Diogo-Spencer/PAC/bomba backup/bomba backup all.SLDASM

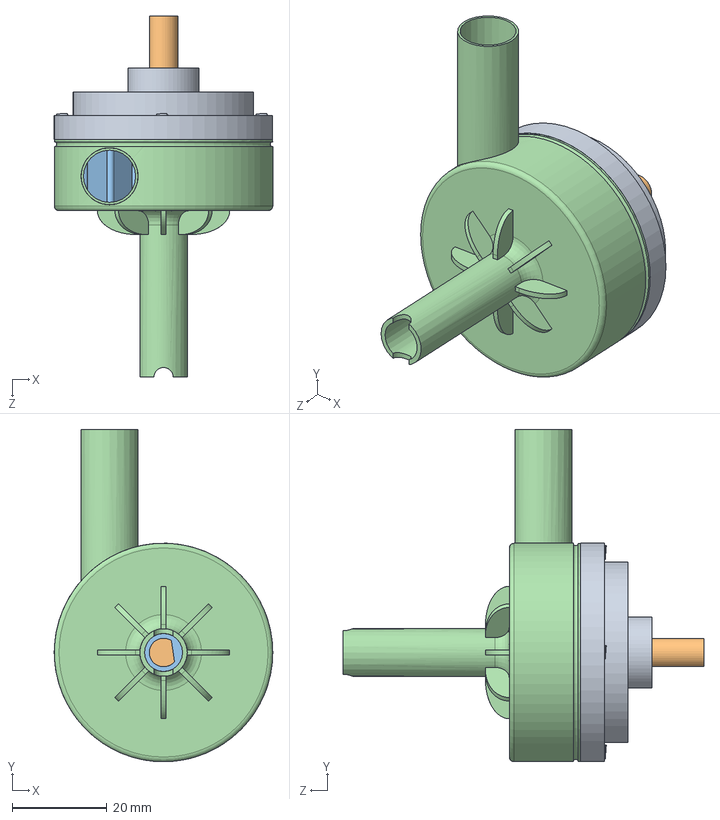
[picture p88: CAD file, 2023-11-21]
bomba backup/bomba backup all.SLDASM
46.0 x 70.0 x 76.0 mm
bomba backup
hélice backup
veio backup
tampa backup
