Diogo-Spencer/PAC/Bomba 80mm/Assem 80mm.SLDASM

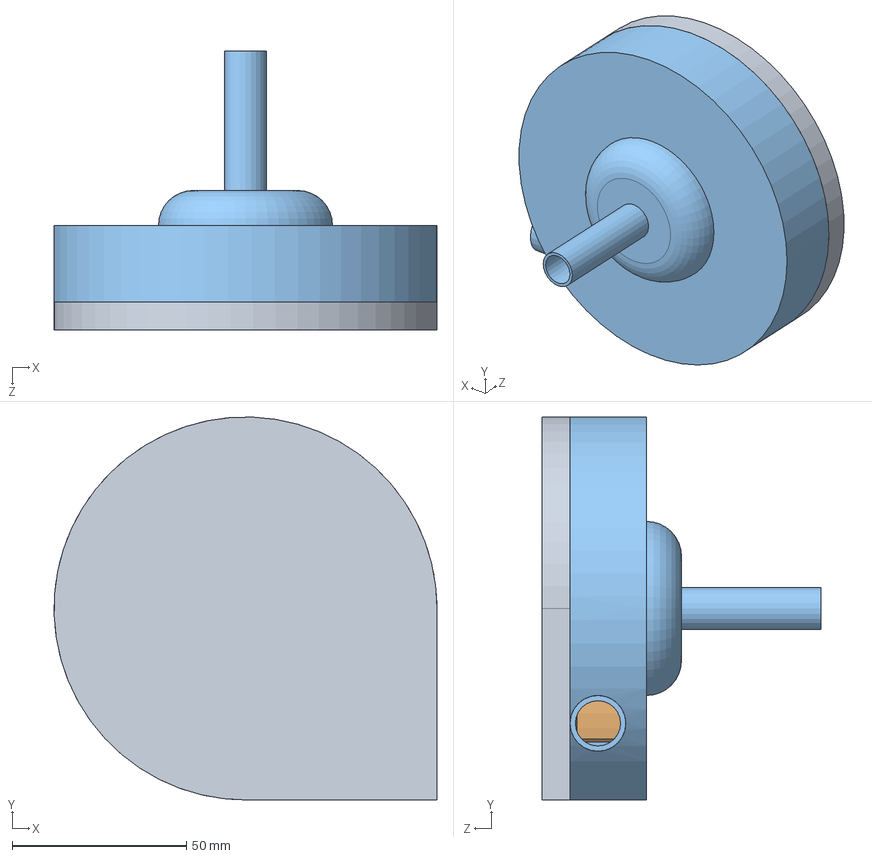
[picture p89: CAD file, 2023-11-29]
Bomba 80mm/Assem 80mm.SLDASM
110.0 x 110.0 x 80.0 mm
Bomba 100mm
Hélice 100 mm
Tampa 80mm
