Diogo-Spencer/PAC/Assem fred.SLDASM

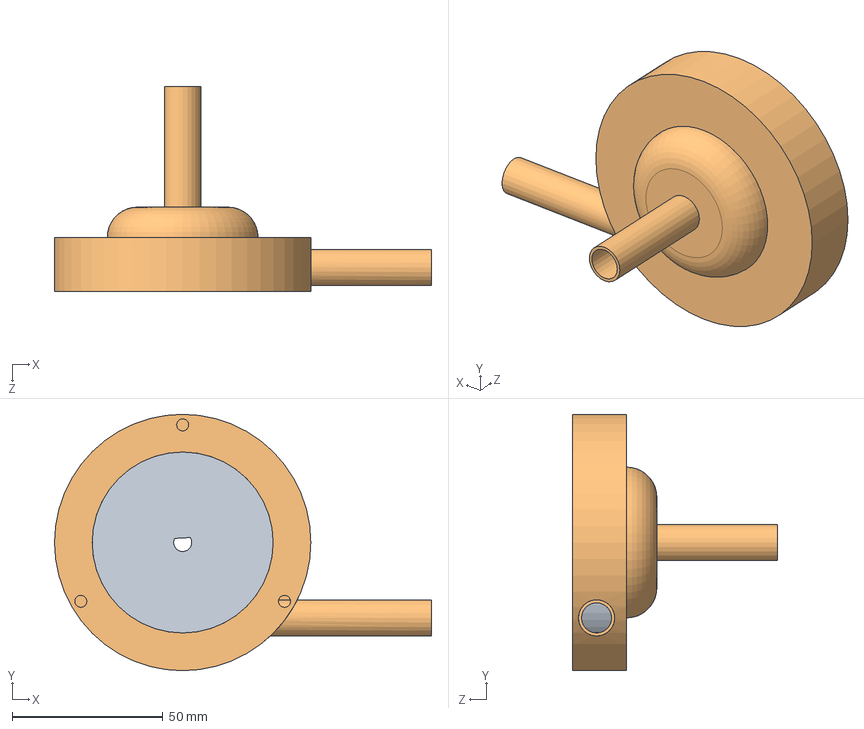
[picture p90: CAD file, 2023-11-28]
Assem fred.SLDASM
125.0 x 85.0 x 68.0 mm
bomba3 fred
helice nova bomba spencer
