Diogo-Spencer/PAC/Bomba Definitiva/Assembley Bomba.SLDASM

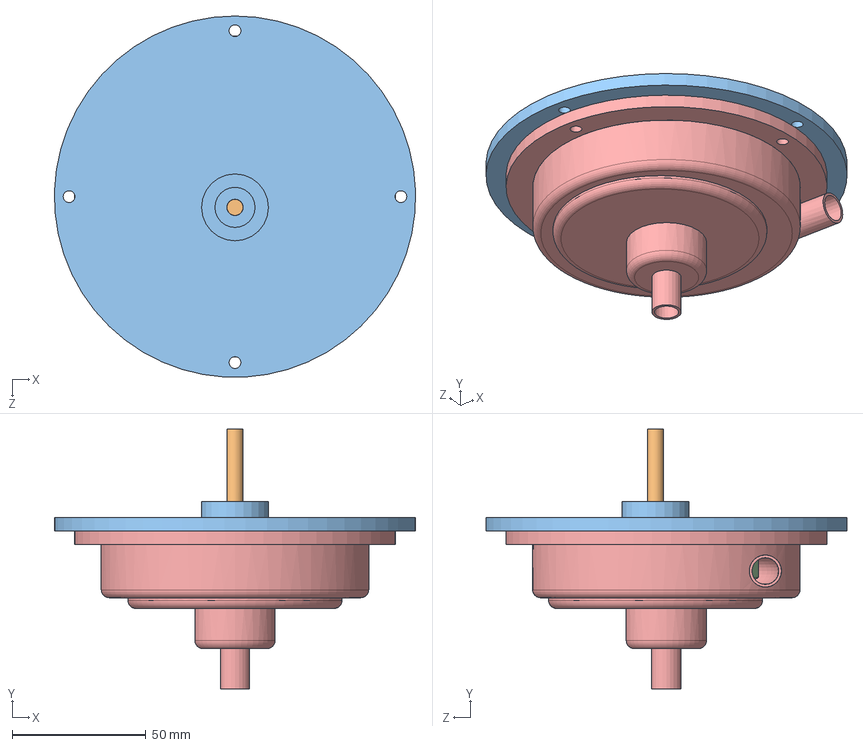
[picture p91: CAD file, 2023-12-01]
Bomba Definitiva/Assembley Bomba.SLDASM
134.9 x 97.0 x 134.9 mm
bomba
hélice
tampa2
Veio
O-ring
