Diogo-Spencer/PAC/Testes e Exames/sim.SLDASM

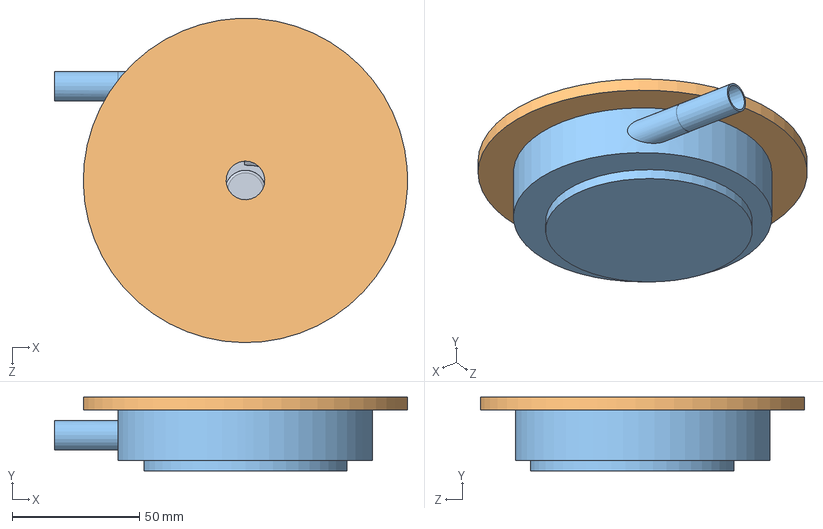
[picture p92: CAD file, 2023-11-30]
Testes e Exames/sim.SLDASM
138.6 x 29.0 x 127.3 mm
bomba simulação
tampa simulação
hélice
