Diogo-Spencer/PAC/Bomba 80mm/Bomba 80mm.SLDPRT

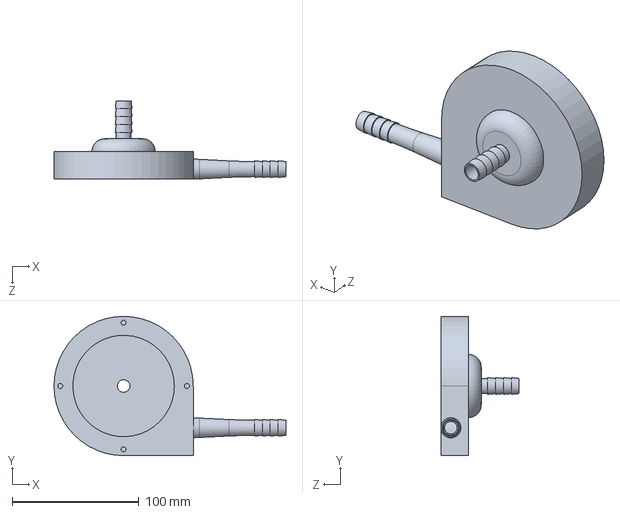
[picture p93: CAD file, 2023-11-30]
Bomba 80mm/Bomba 80mm.SLDPRT
183.3 x 110.0 x 62.0 mm
