Diogo-Spencer/PAC/bomba backup/hélice backup.SLDPRT

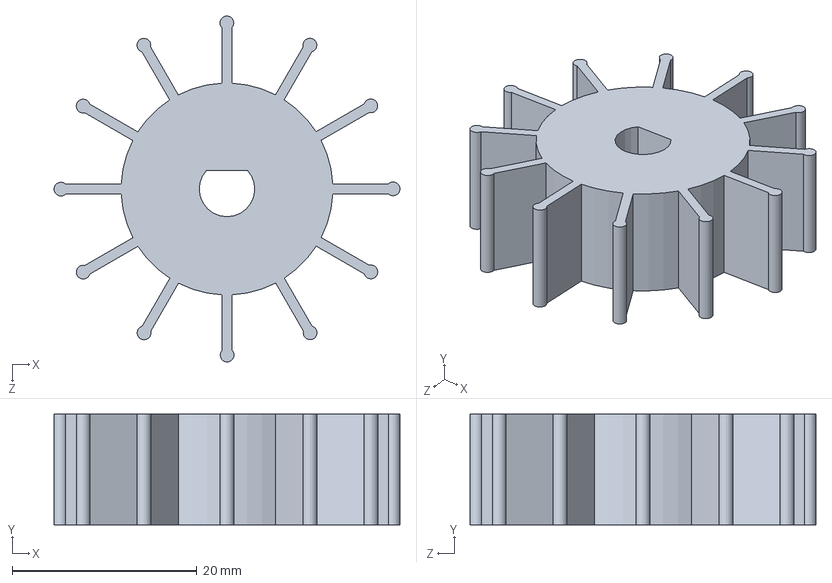
[picture p94: CAD file, 2023-11-21]
bomba backup/hélice backup.SLDPRT
37.4 x 12.0 x 37.4 mm
