Diogo-Spencer/PAC/Bomba Definitiva/hélice 3.SLDPRT

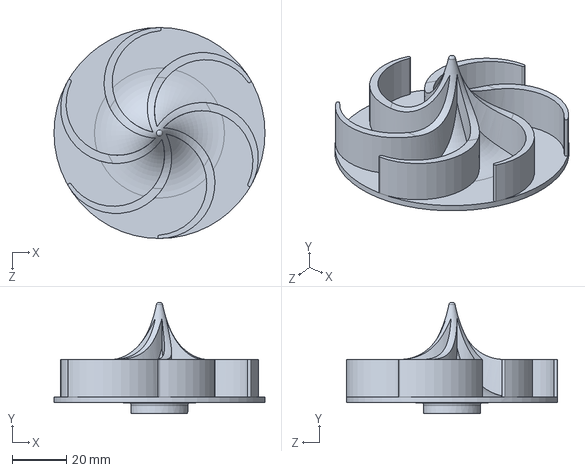
[picture p95: CAD file, 2023-12-06]
Bomba Definitiva/hélice 3.SLDPRT
78.0 x 41.1 x 78.0 mm
