Diogo-Spencer/PAC/bomba.3mf

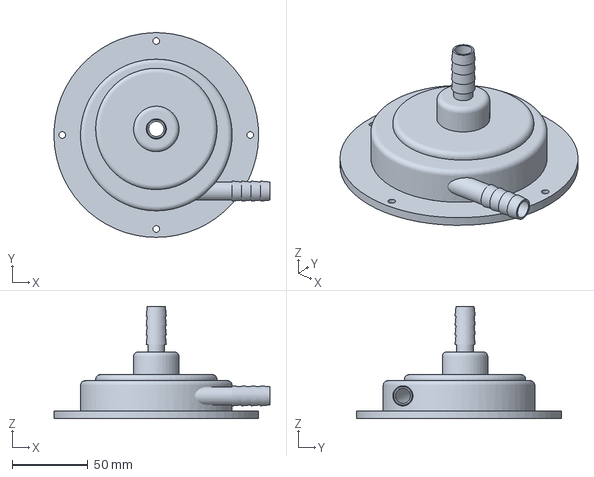
[picture p96: CAD file, 2023-12-04]
bomba.3mf
142.5 x 135.0 x 74.0 mm
