Diogo-Spencer/PAC/Testes e Exames/hélice.SLDPRT

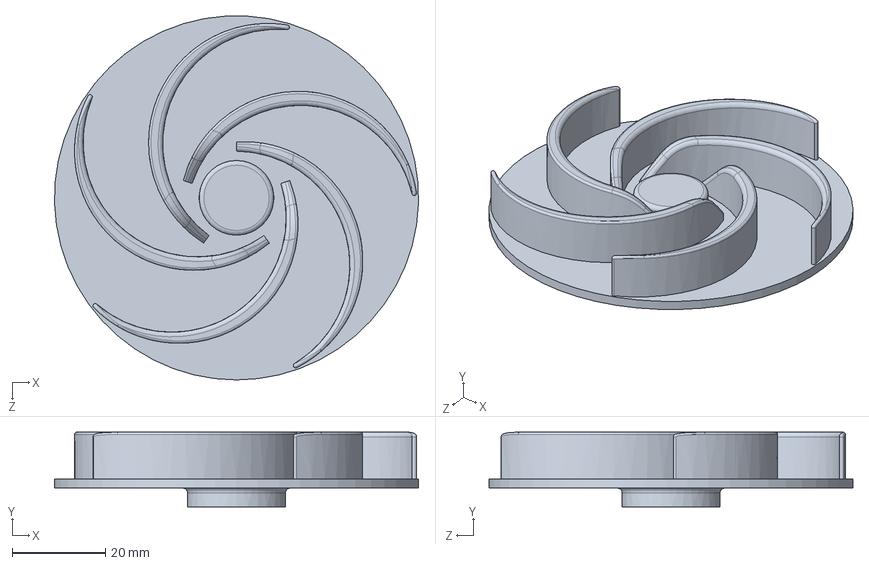
[picture p97: CAD file, 2023-11-30]
Testes e Exames/hélice.SLDPRT
78.0 x 16.0 x 77.9 mm
