Diogo-Spencer/PAC/Bomba 80mm/Hélice 80mm.SLDPRT

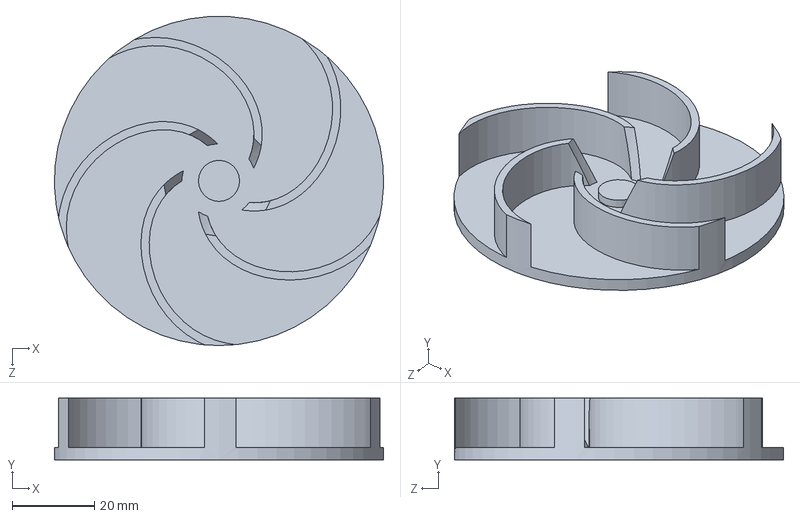
[picture p98: CAD file, 2023-11-30]
Bomba 80mm/Hélice 80mm.SLDPRT
80.0 x 15.0 x 79.9 mm
