Diogo-Spencer/PAC/bomba backup/bomba backup.SLDPRT

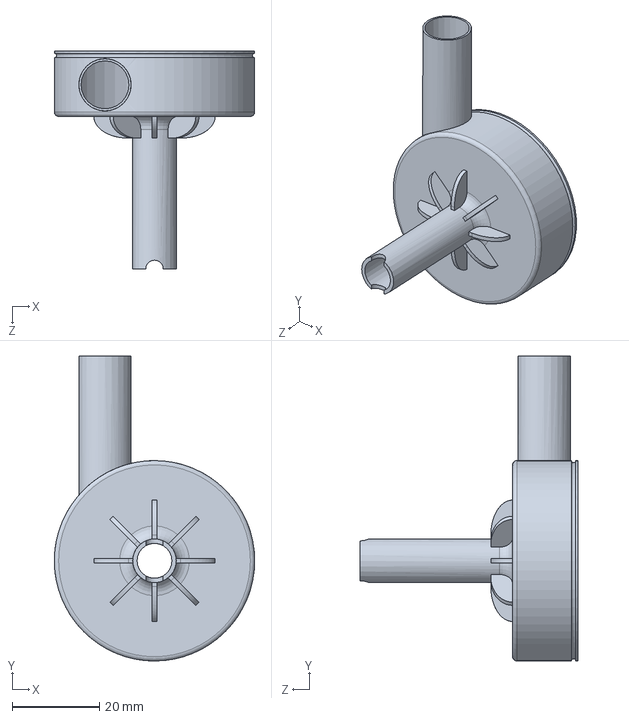
[picture p99: CAD file, 2023-11-21]
bomba backup/bomba backup.SLDPRT
46.0 x 70.0 x 50.0 mm
