Diogo-Spencer/PAC/Bomba Definitiva/hélice 2.SLDPRT

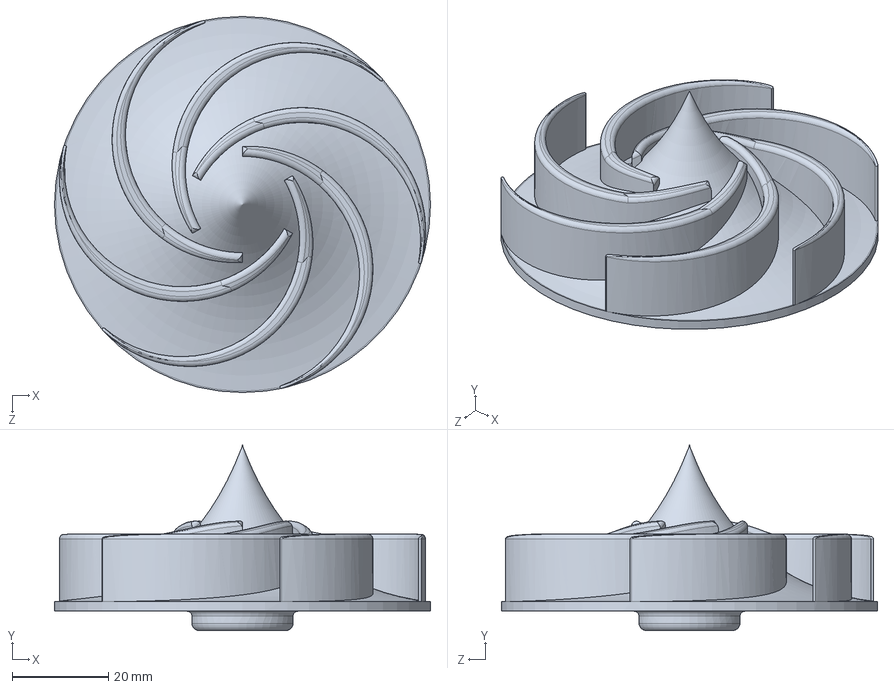
[picture p100: CAD file, 2023-12-06]
Bomba Definitiva/hélice 2.SLDPRT
78.0 x 38.4 x 78.0 mm
