Diogo-Spencer/PAC/Hélice 100 mm.SLDPRT

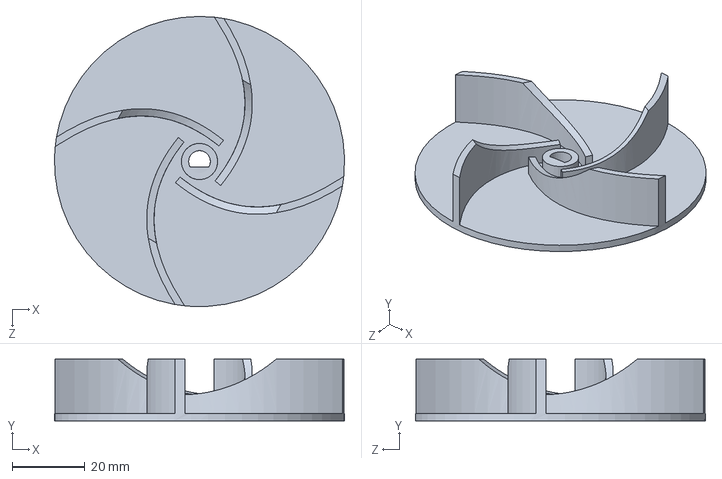
[picture p101: CAD file, 2023-11-28]
Hélice 100 mm.SLDPRT
80.0 x 17.0 x 80.0 mm
