Diogo-Spencer/PAC/sld/veio 3.SLDPRT

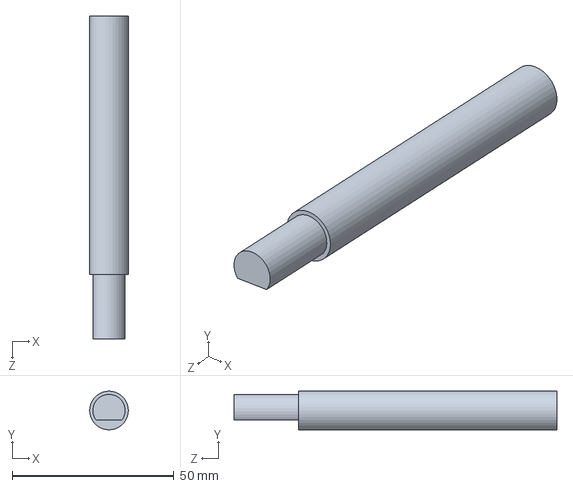
[picture p102: CAD file, 2023-11-26]
sld/veio 3.SLDPRT
12.0 x 12.0 x 100.0 mm
