Diogo-Spencer/PAC/Testes e Exames/bomba.SLDPRT

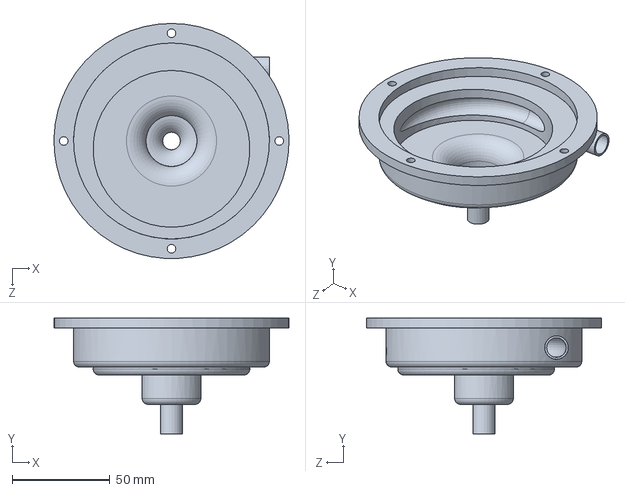
[picture p103: CAD file, 2023-11-30]
Testes e Exames/bomba.SLDPRT
119.9 x 59.0 x 120.0 mm
