Diogo-Spencer/PAC/Bomba 100mm.SLDPRT

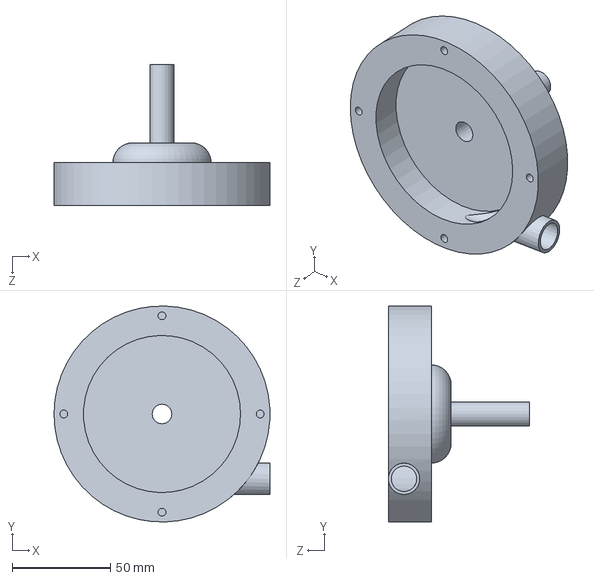
[picture p104: CAD file, 2023-11-28]
Bomba 100mm.SLDPRT
110.0 x 109.9 x 72.0 mm
