Diogo-Spencer/PAC/Bomba 80mm/dummy.SLDPRT

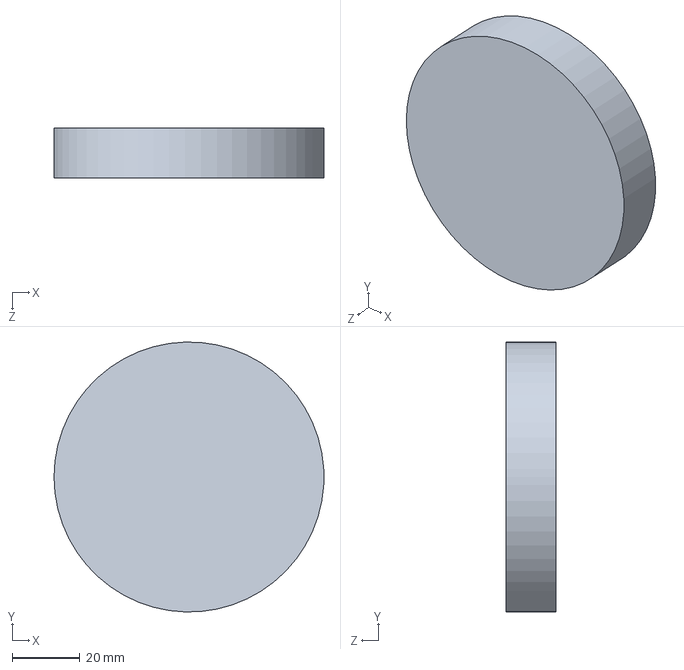
[picture p105: CAD file, 2023-11-30]
Bomba 80mm/dummy.SLDPRT
79.9 x 79.9 x 14.9 mm
