Diogo-Spencer/PAC/bomba backup/veio backup.SLDPRT

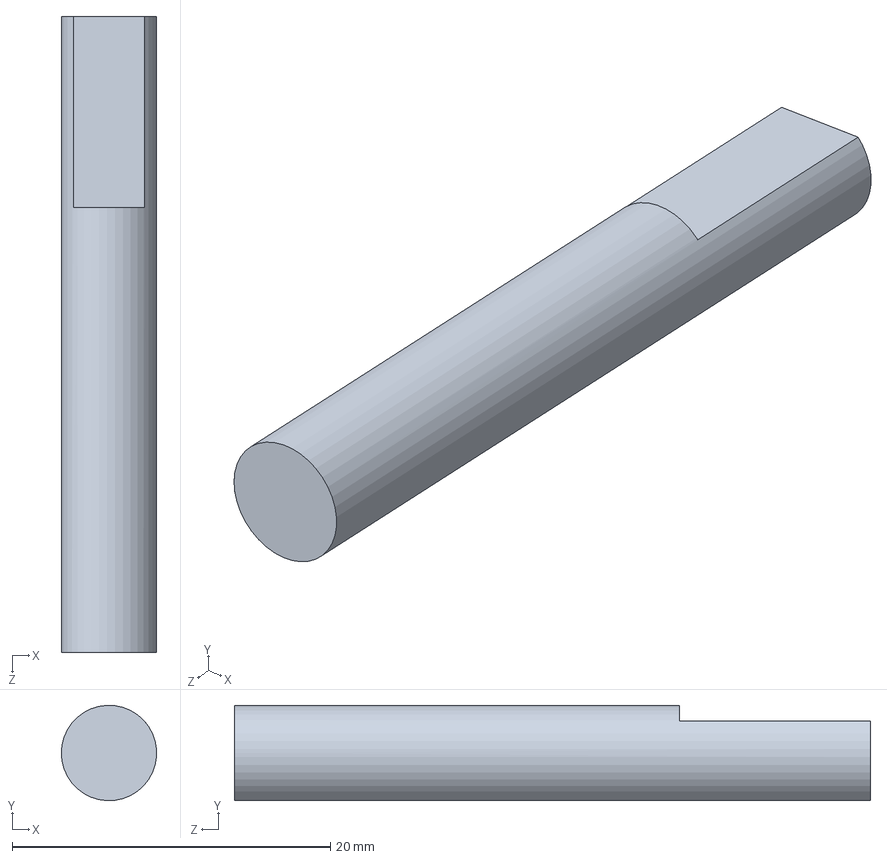
[picture p106: CAD file, 2023-11-21]
bomba backup/veio backup.SLDPRT
6.00 x 5.99 x 40.0 mm
