Diogo-Spencer/PAC/sld/dummy 3.SLDPRT

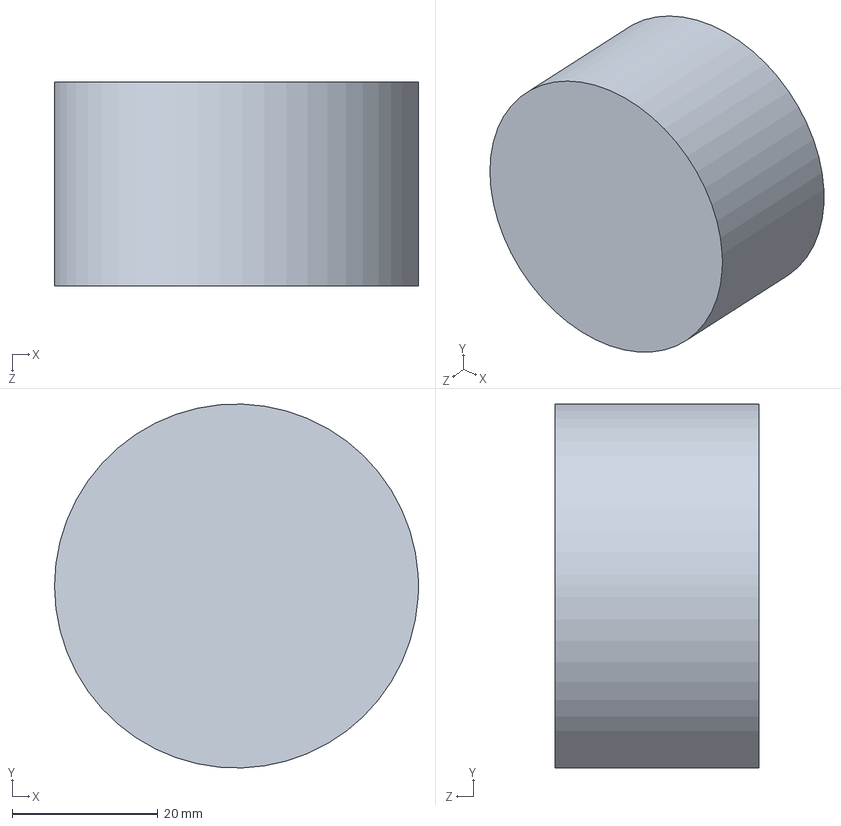
[picture p107: CAD file, 2023-11-26]
sld/dummy 3.SLDPRT
50.0 x 50.0 x 28.0 mm
