Diogo-Spencer/PAC/Testes e Exames/dumy.SLDPRT

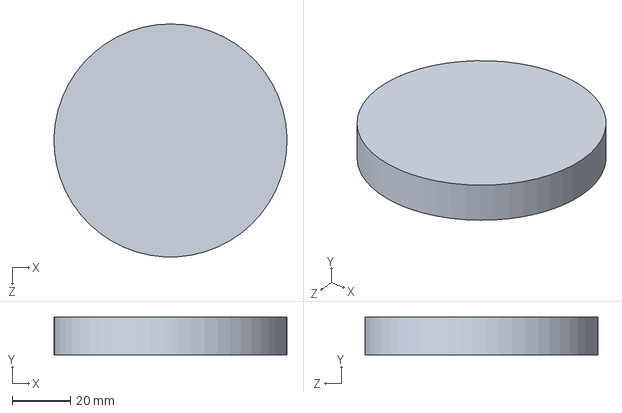
[picture p108: CAD file, 2023-11-30]
Testes e Exames/dumy.SLDPRT
80.0 x 13.0 x 80.0 mm
