Diogo-Spencer/PAC/Bomba 80mm/Tampa 80mm.SLDPRT

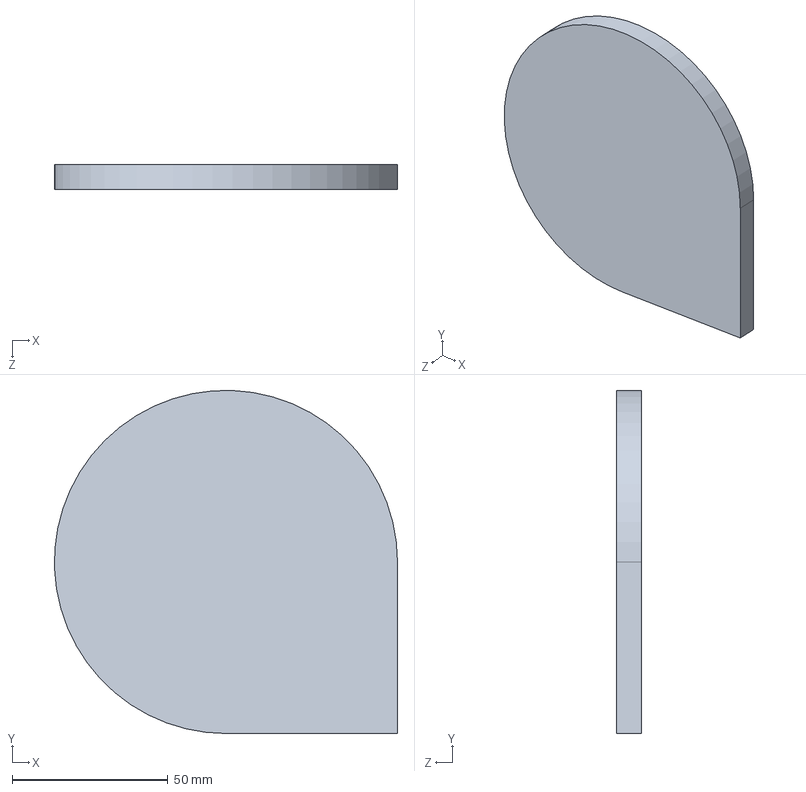
[picture p109: CAD file, 2023-11-29]
Bomba 80mm/Tampa 80mm.SLDPRT
110.0 x 110.0 x 8.00 mm
