Diogo-Spencer/PAC/Bomba Definitiva/hélice.SLDPRT

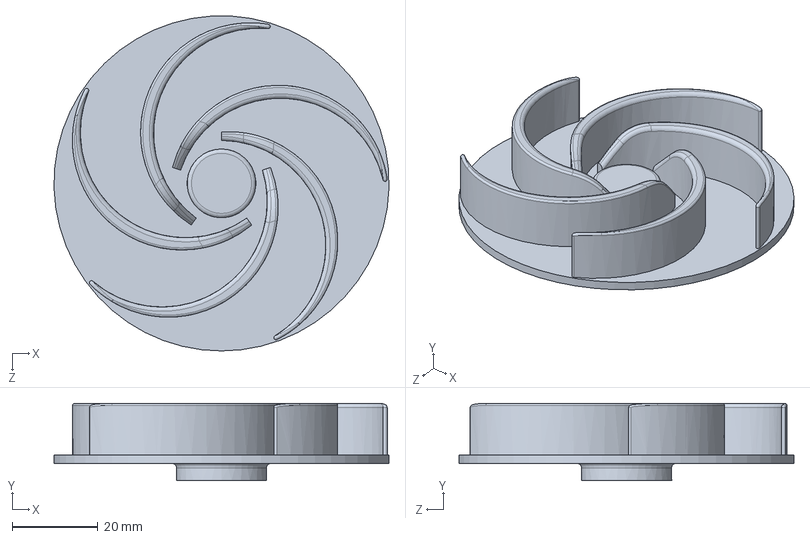
[picture p110: CAD file, 2023-12-01]
Bomba Definitiva/hélice.SLDPRT
78.0 x 18.0 x 77.9 mm
