Diogo-Spencer/PAC/helice nova bomba spencer 8 pazes.SLDPRT

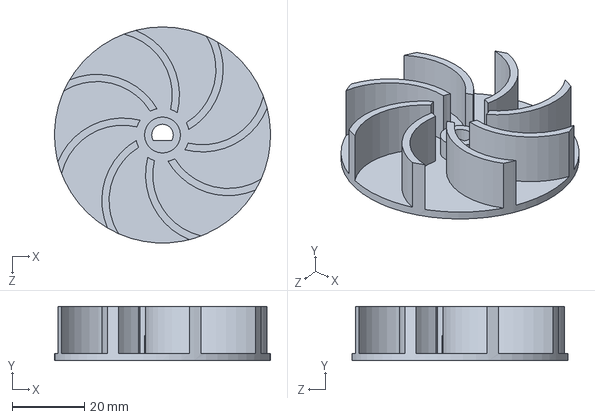
[picture p111: CAD file, 2023-11-28]
helice nova bomba spencer 8 pazes.SLDPRT
60.0 x 15.0 x 60.0 mm
