Diogo-Spencer/PAC/bomba backup/tampa backup.SLDPRT

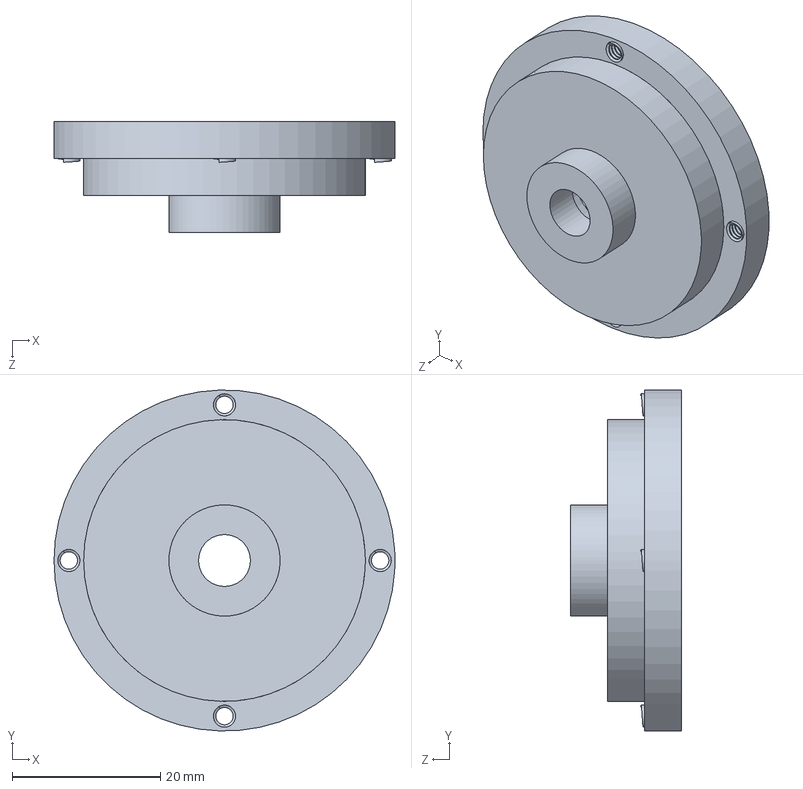
[picture p112: CAD file, 2023-11-21]
bomba backup/tampa backup.SLDPRT
46.0 x 46.0 x 15.0 mm
