Diogo-Spencer/PAC/Bomba Definitiva/tampa2.SLDPRT

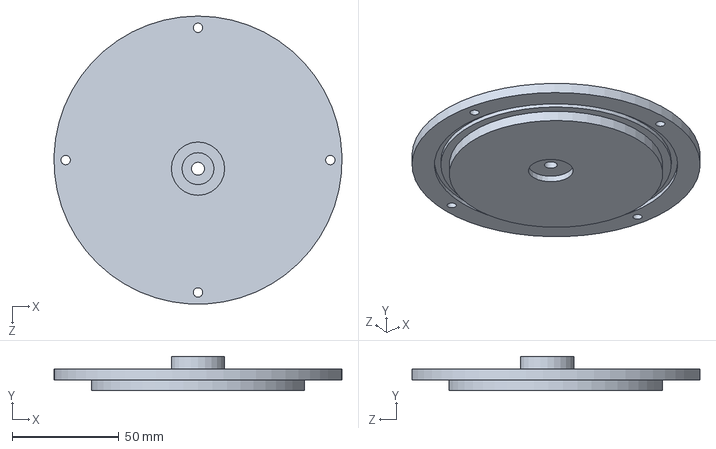
[picture p113: CAD file, 2023-12-01]
Bomba Definitiva/tampa2.SLDPRT
134.9 x 16.0 x 134.9 mm
