Diogo-Spencer/PAC/helice nova bomba spencer 4 pazes.SLDPRT

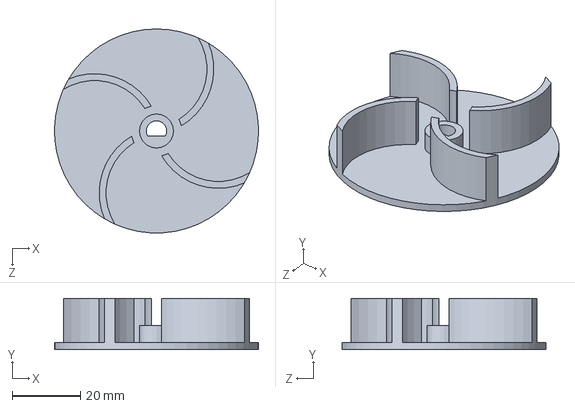
[picture p114: CAD file, 2023-11-28]
helice nova bomba spencer 4 pazes.SLDPRT
60.0 x 15.0 x 60.0 mm
