Diogo-Spencer/PAC/Testes e Exames/tampa simulação.SLDPRT

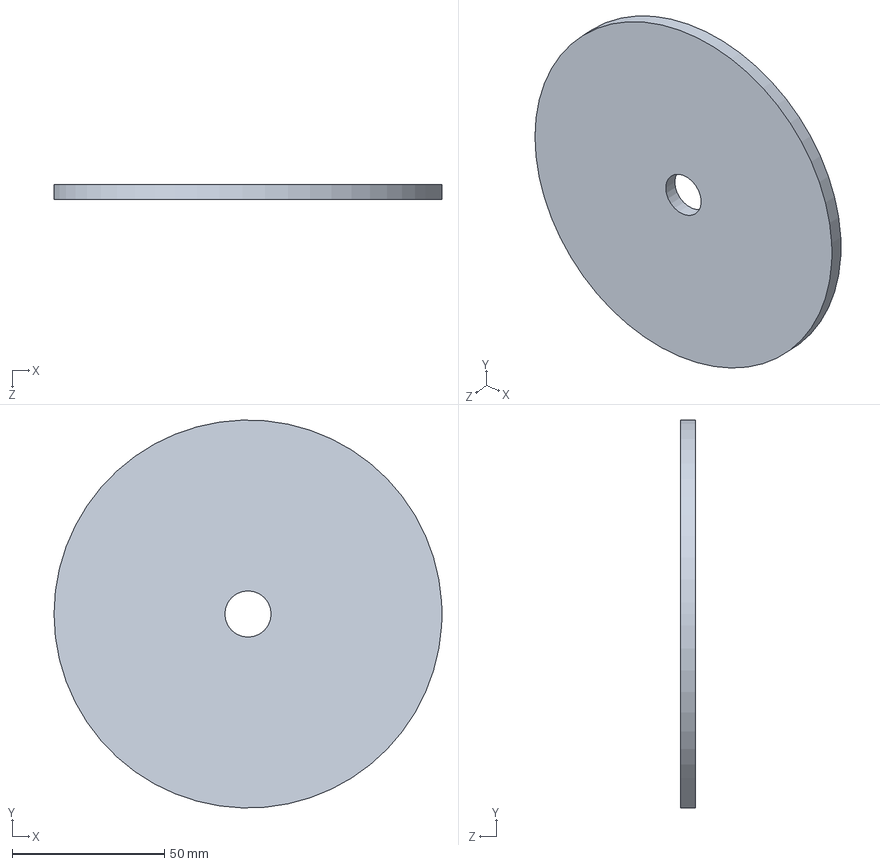
[picture p115: CAD file, 2023-11-30]
Testes e Exames/tampa simulação.SLDPRT
127.4 x 127.3 x 5.00 mm
