Diogo-Spencer/PAC/bomba backup/dummy backup.SLDPRT

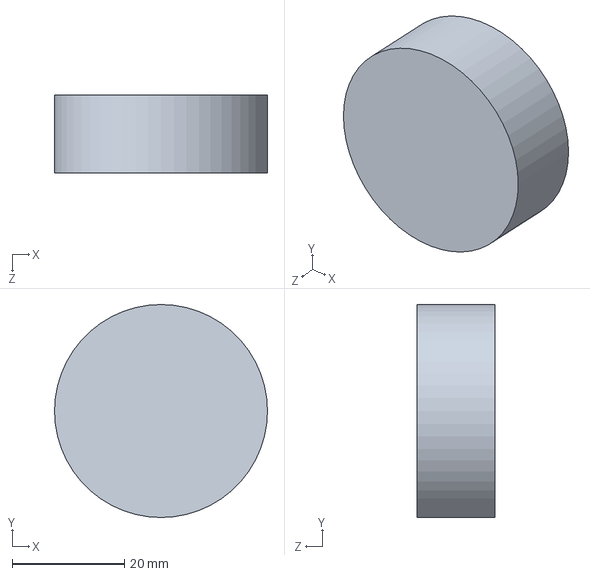
[picture p116: CAD file, 2023-11-21]
bomba backup/dummy backup.SLDPRT
38.0 x 38.0 x 14.0 mm
