Diogo-Spencer/PAC/Testes e Exames/tampa2.SLDPRT

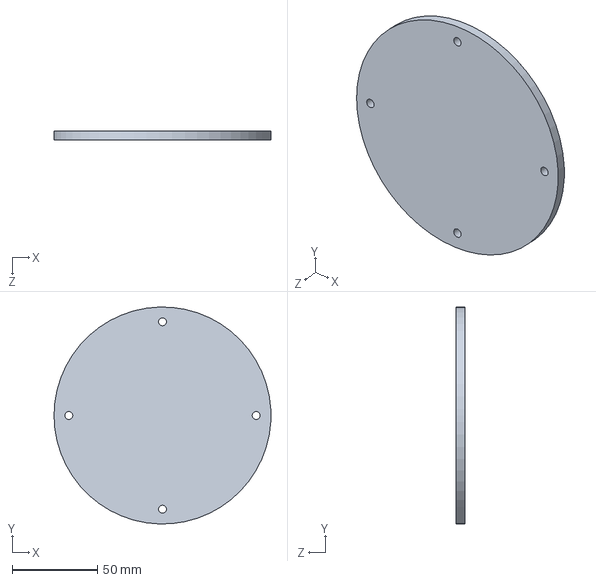
[picture p117: CAD file, 2023-11-30]
Testes e Exames/tampa2.SLDPRT
127.4 x 127.3 x 5.00 mm
