Diogo-Spencer/PAC/Bomba Definitiva/Veio.SLDPRT

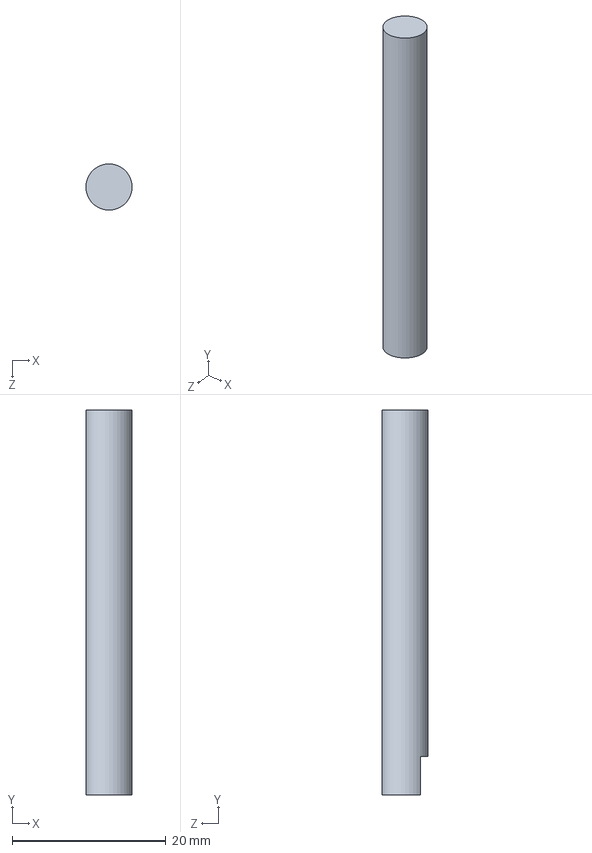
[picture p118: CAD file, 2023-12-01]
Bomba Definitiva/Veio.SLDPRT
6.00 x 50.0 x 6.00 mm
