Diogo-Spencer/PAC/bomba3 fred.SLDPRT

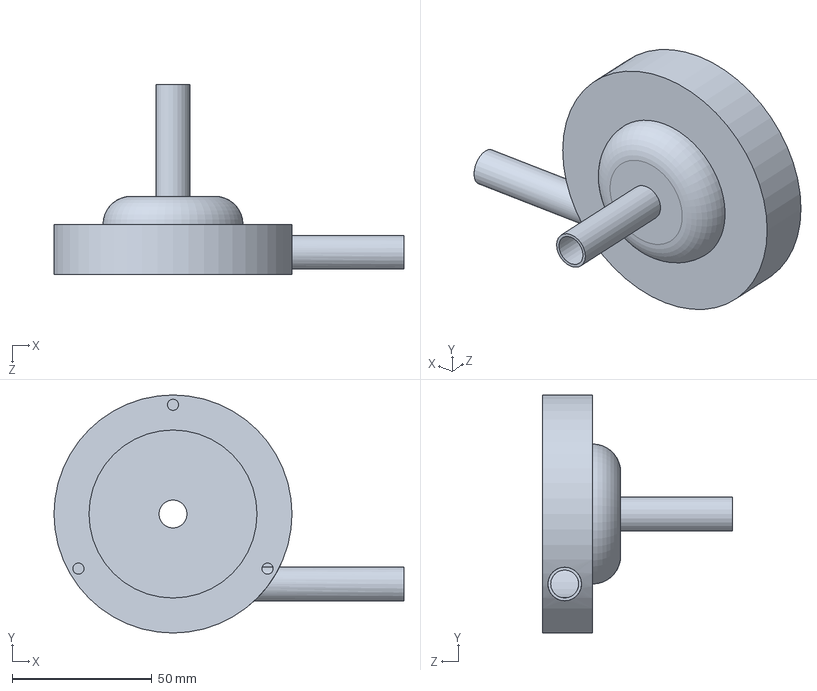
[picture p119: CAD file, 2023-11-28]
bomba3 fred.SLDPRT
125.0 x 85.0 x 68.0 mm
