Diogo-Spencer/PAC/Testes e Exames/bomba simulação .SLDPRT

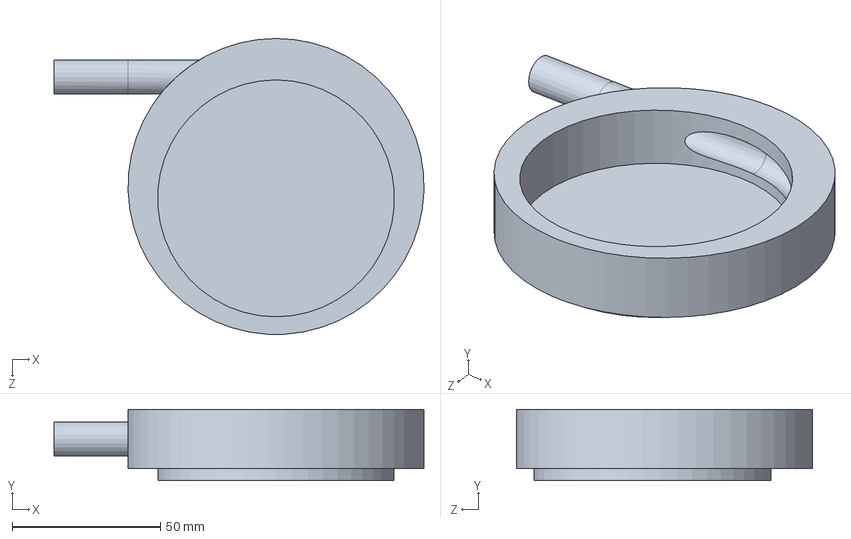
[picture p120: CAD file, 2023-11-30]
Testes e Exames/bomba simulação .SLDPRT
125.0 x 24.0 x 100.0 mm
