Diogo-Spencer/PAC/Bomba Definitiva/O-ring.SLDPRT

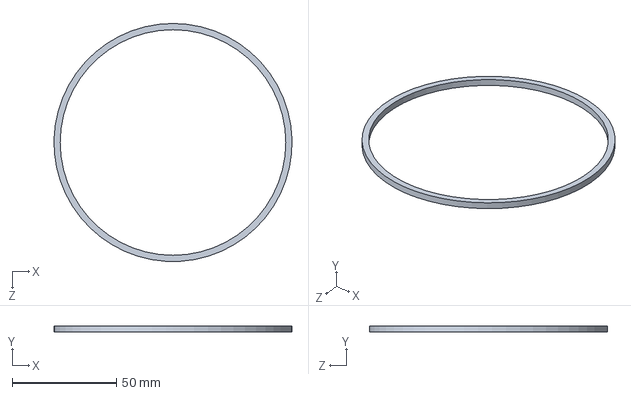
[picture p121: CAD file, 2023-12-01]
Bomba Definitiva/O-ring.SLDPRT
113.9 x 3.00 x 114.0 mm
