Diogo-Spencer/PAC/helice nova bomba spencer.SLDPRT

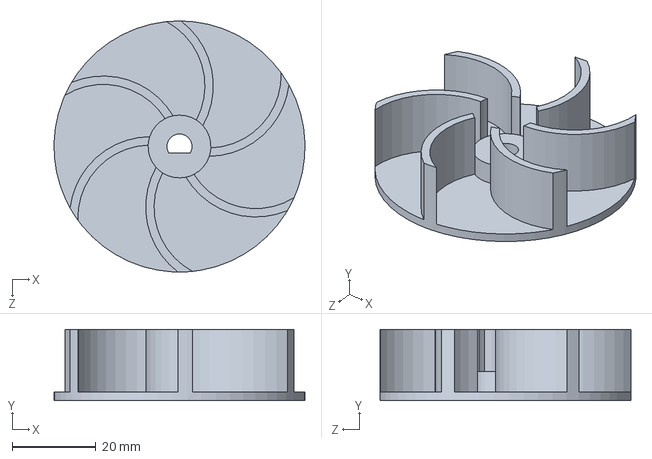
[picture p122: CAD file, 2023-11-28]
helice nova bomba spencer.SLDPRT
60.0 x 17.0 x 60.0 mm
