Diogo-Spencer/PAC/helice 3 fred.SLDPRT

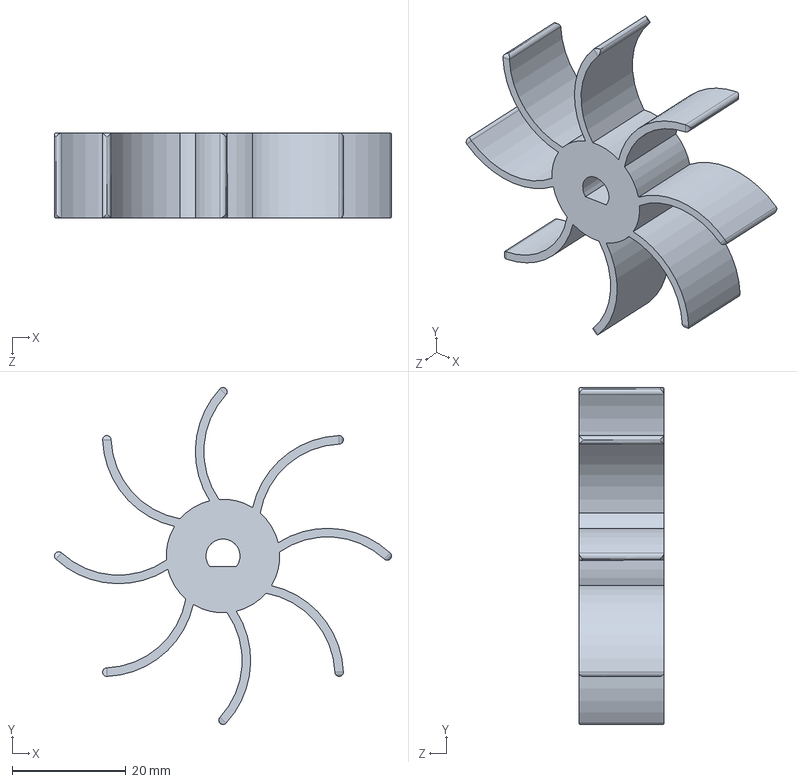
[picture p123: CAD file, 2023-11-28]
helice 3 fred.SLDPRT
59.3 x 59.3 x 15.0 mm
