Diogo-Spencer/PAC/bomba3 fred final.SLDPRT

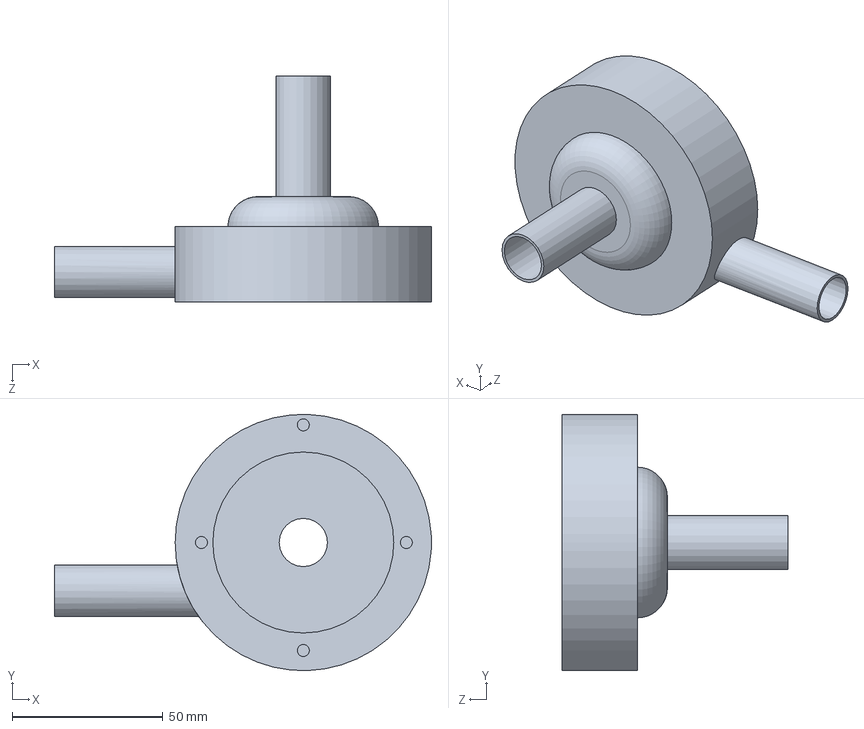
[picture p124: CAD file, 2023-11-28]
bomba3 fred final.SLDPRT
125.0 x 85.0 x 75.0 mm
