Diogo-Spencer/PAC/last.SLDPRT

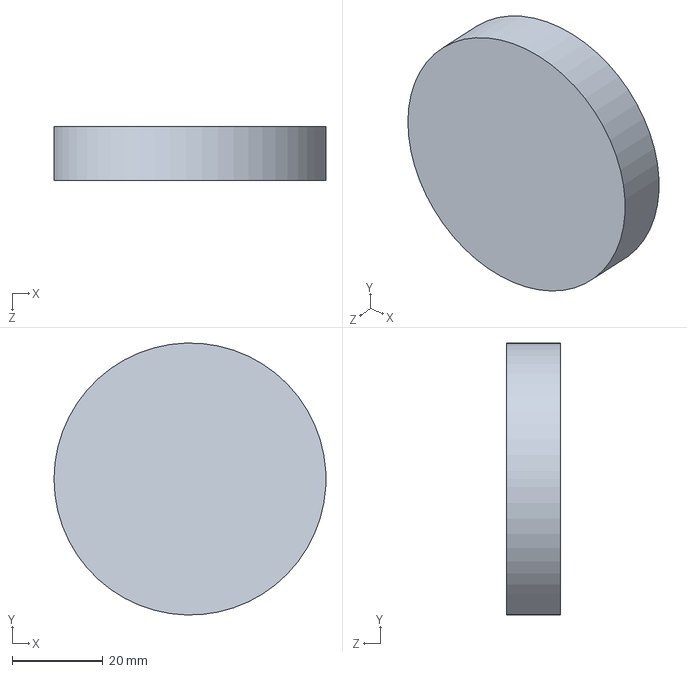
[picture p125: CAD file, 2023-11-28]
last.SLDPRT
60.0 x 60.0 x 12.0 mm
