Diogo-Spencer/PAC/helice 3 fred final.SLDPRT

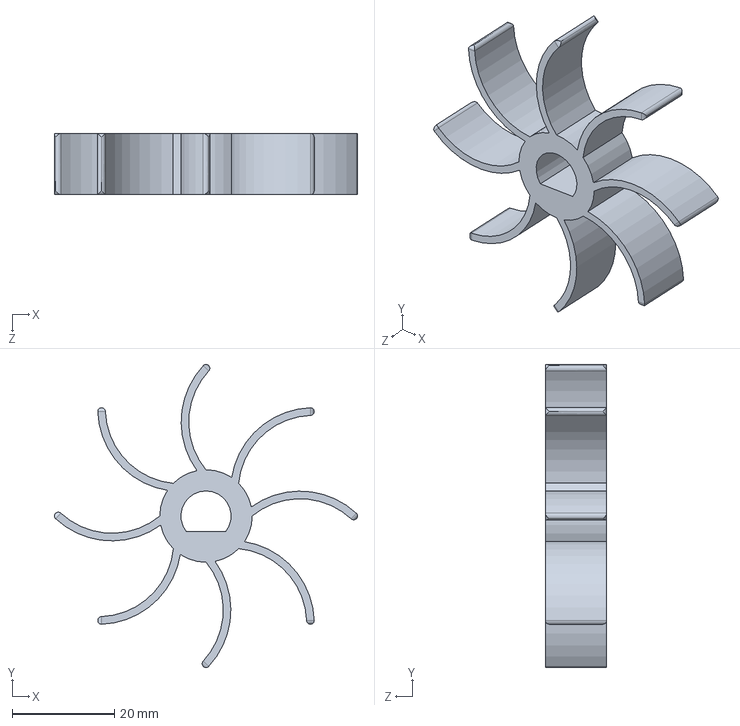
[picture p126: CAD file, 2023-11-28]
helice 3 fred final.SLDPRT
59.3 x 59.3 x 12.0 mm
