Diogo-Spencer/PAC/sld/tampa3.SLDPRT

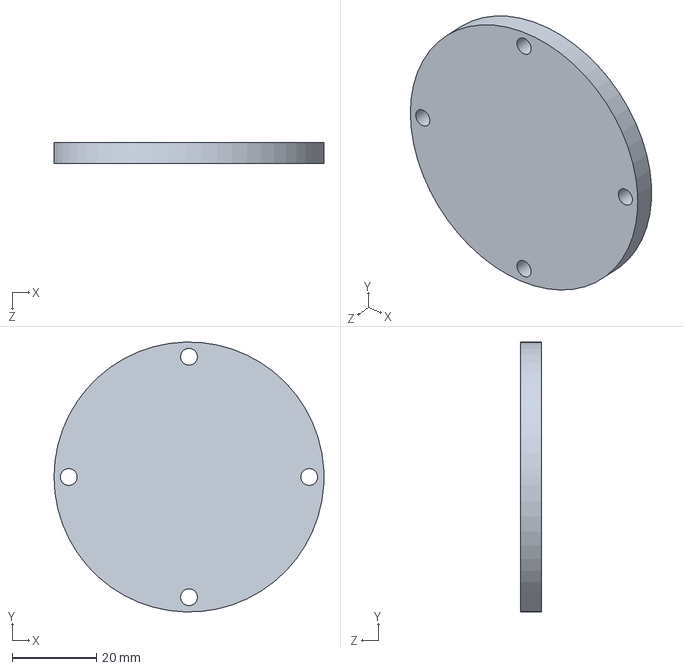
[picture p127: CAD file, 2023-11-26]
sld/tampa3.SLDPRT
64.0 x 64.0 x 5.00 mm
