Diogo-Spencer/PAC/Bomba anterior aumentada ´fred.SLDPRT

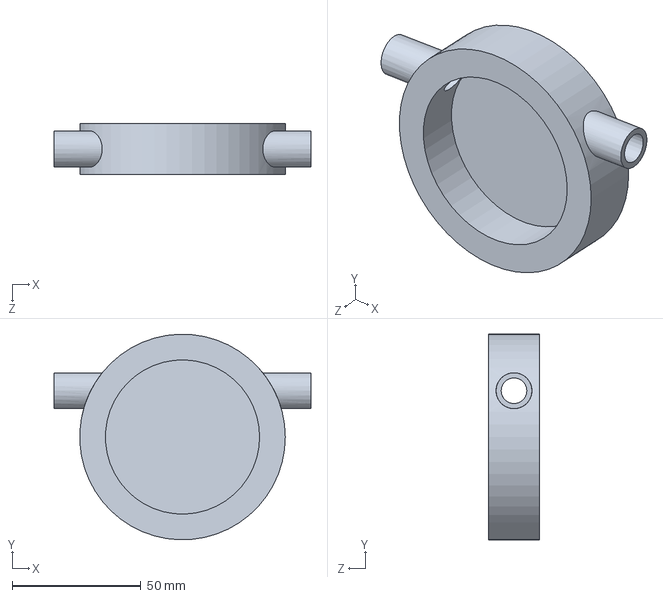
[picture p128: CAD file, 2023-11-27]
Bomba anterior aumentada ´fred.SLDPRT
100.0 x 80.0 x 20.0 mm
