Diogo-Spencer/PAC/sld/helice 3.SLDPRT

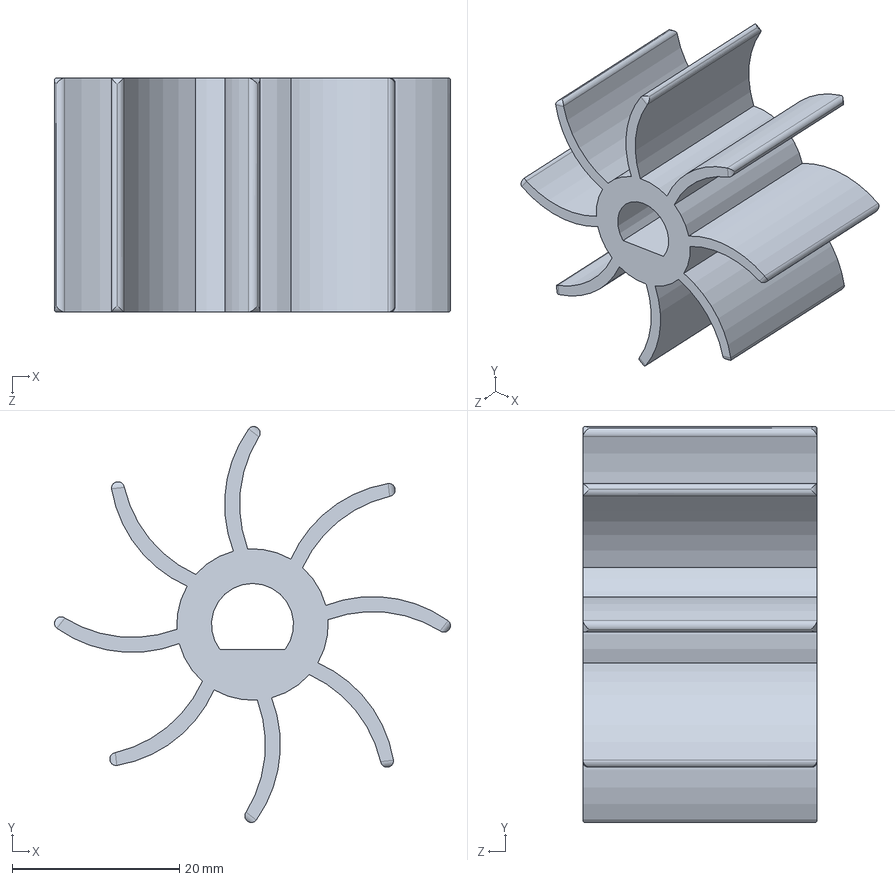
[picture p129: CAD file, 2023-11-26]
sld/helice 3.SLDPRT
47.4 x 47.4 x 28.0 mm
