Diogo-Spencer/PAC/SuporteBomba (1).SLDPRT

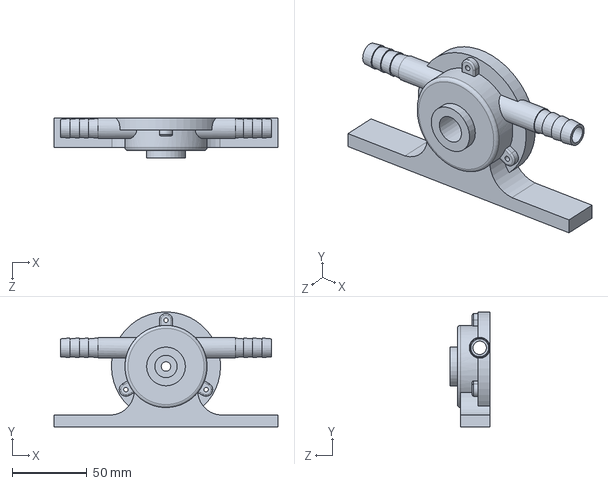
[picture p130: CAD file, 2023-11-17]
SuporteBomba (1).SLDPRT
150.0 x 76.9 x 27.0 mm
