Diogo-Spencer/PAC/Tampa.SLDPRT

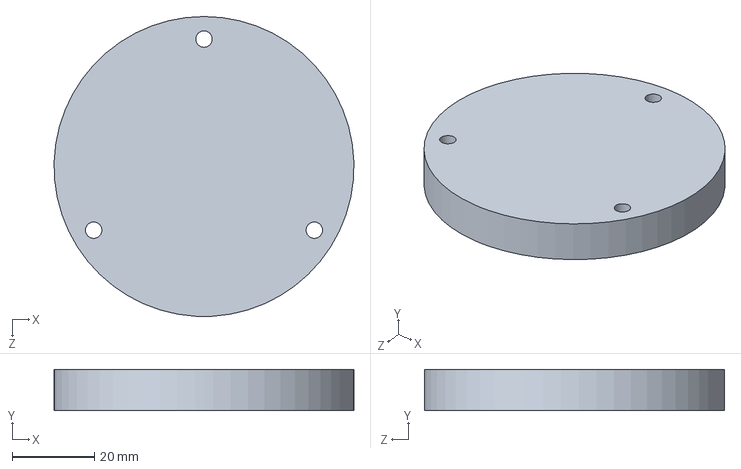
[picture p131: CAD file, 2023-11-14]
Tampa.SLDPRT
73.0 x 10.0 x 73.0 mm
