Diogo-Spencer/PAC/hélice.SLDPRT

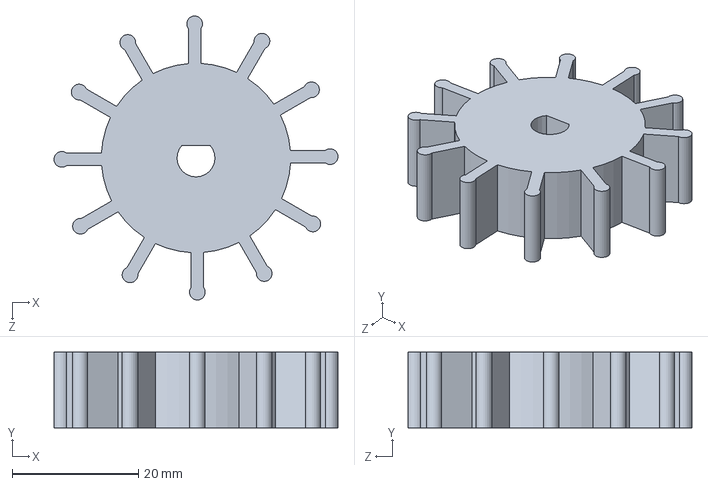
[picture p132: CAD file, 2023-11-14]
hélice.SLDPRT
45.0 x 12.0 x 45.0 mm
