Diogo-Spencer/PAC/o-ring.SLDPRT

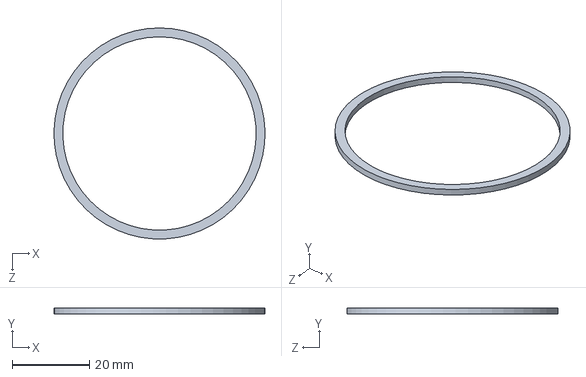
[picture p133: CAD file, 2023-11-11]
o-ring.SLDPRT
54.6 x 1.50 x 54.6 mm
