Diogo-Spencer/PAC/Hose Fitting.SLDPRT

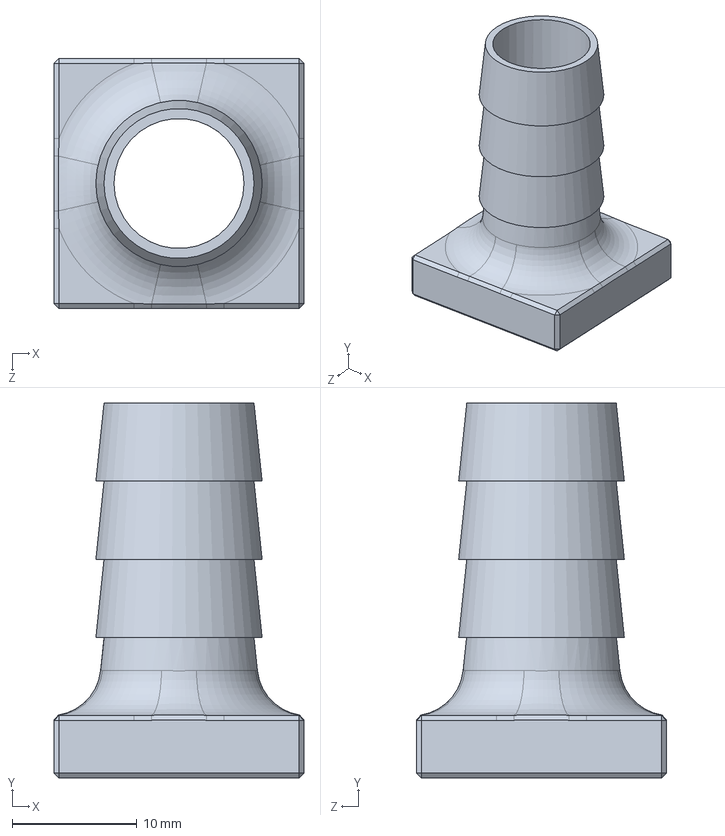
[picture p134: CAD file, 2023-11-07]
Hose Fitting.SLDPRT
20.0 x 30.0 x 20.0 mm
