Diogo-Spencer/PAC/sld/bomba3.2.SLDASM

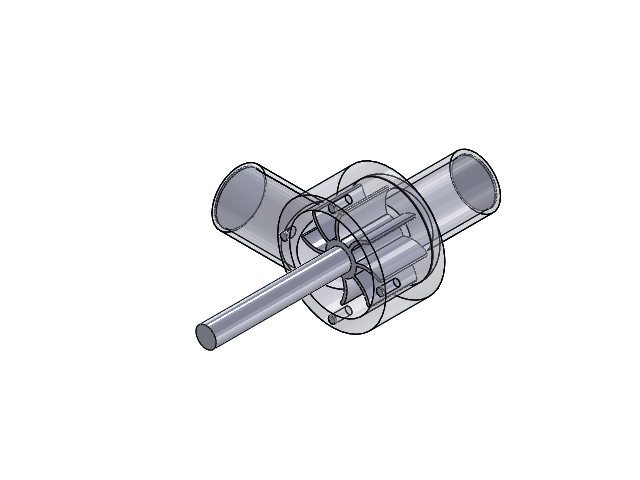
[picture p135: CAD file, 2023-11-26]
sld/bomba3.2.SLDASM
bomba3
helice 3
veio 3
LID23
LID24
LID25
LID26
LID28
LID29
