Diogo-Spencer/PAC/Assem bomba antiga fred.SLDASM

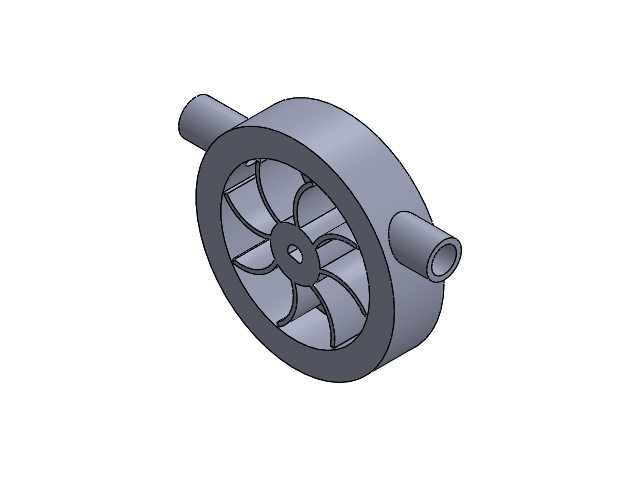
[picture p136: CAD file, 2023-11-28]
Assem bomba antiga fred.SLDASM
Bomba anterior aumentada ´fred
helice 3 fred
