Diogo-Spencer/PAC/Testes e Exames/bomba nova.SLDASM

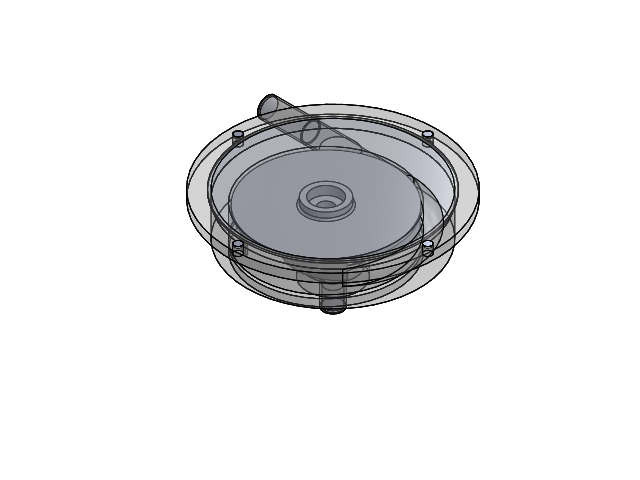
[picture p137: CAD file, 2023-11-30]
Testes e Exames/bomba nova.SLDASM
bomba
hélice
LID3
LID4
LID5
LID6
LID7
LID8
LID9
