Diogo-Spencer/PAC/sld/bomba 3.SLDASM

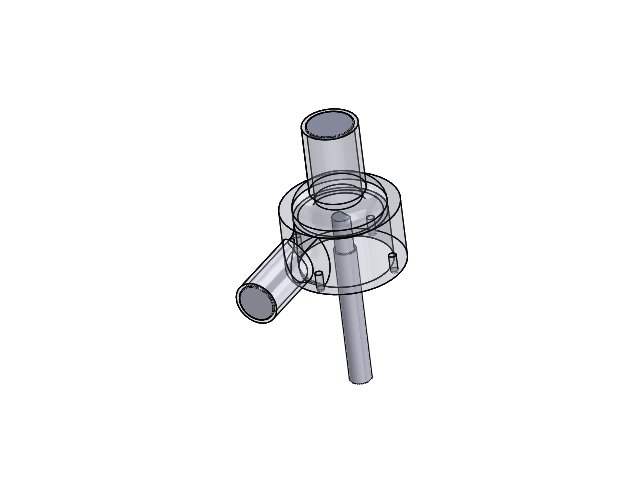
[picture p138: CAD file, 2023-11-26]
sld/bomba 3.SLDASM
bomba3
veio 3
LID8
LID9
LID10
LID11
LID12
LID13
LID14
