Diogo-Spencer/PAC/Assem fred final.SLDASM

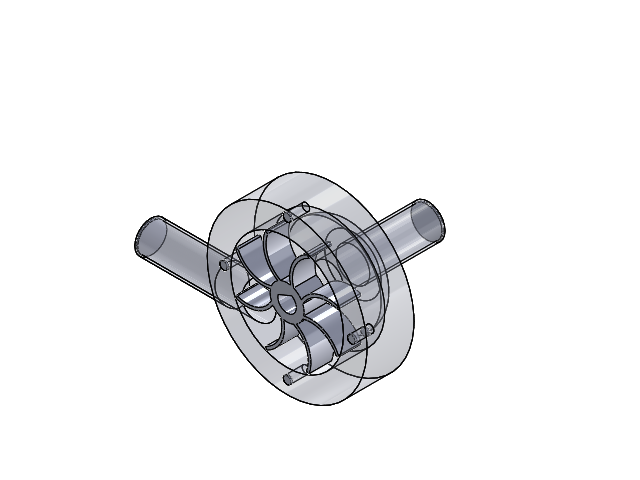
[picture p139: CAD file, 2023-11-28]
Assem fred final.SLDASM
bomba3 fred
helice 3 fred
LID39
LID47
LID48
LID49
LID50
LID51
LID52
