Diogo-Spencer/PAC/Assem1.SLDASM

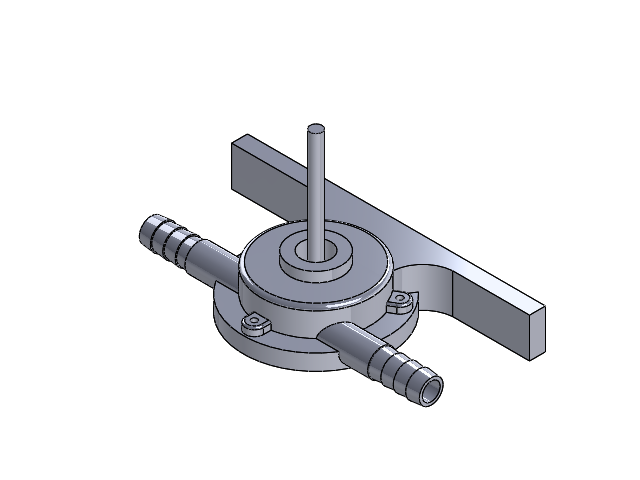
[picture p140: CAD file, 2023-11-17]
Assem1.SLDASM
SuporteBomba (1)
hélice
Veio Hélice
o-ring
