Diogo-Spencer/PAC/(list of files, cad)

Other CAD files:
Bomba Definitiva/bomba.SLDPRT
sld/LID24.SLDPRT
Testes e Exames/LID3.SLDPRT
sld/LID18.SLDPRT
sld/LID26.SLDPRT
sld/LID16.SLDPRT
sld/LID20.SLDPRT
sld/LID17.SLDPRT
Testes e Exames/LID4.SLDPRT
sld/LID23.SLDPRT
sld/LID15.SLDPRT
sld/LID28.SLDPRT
sld/LID29.SLDPRT
sld/LID19.SLDPRT
sld/LID22.SLDPRT
sld/LID21.SLDPRT
sld/LID25.SLDPRT
sld/LID27.SLDPRT
Veio Hélice.SLDPRT
O-ring.3mf
hélice.3mf
sld/bomba3.SLDPRT
